Tai-Min/Farelka/hw/dummy_load/step/SK68-50SAFISCHER ELEKTRONIK.step

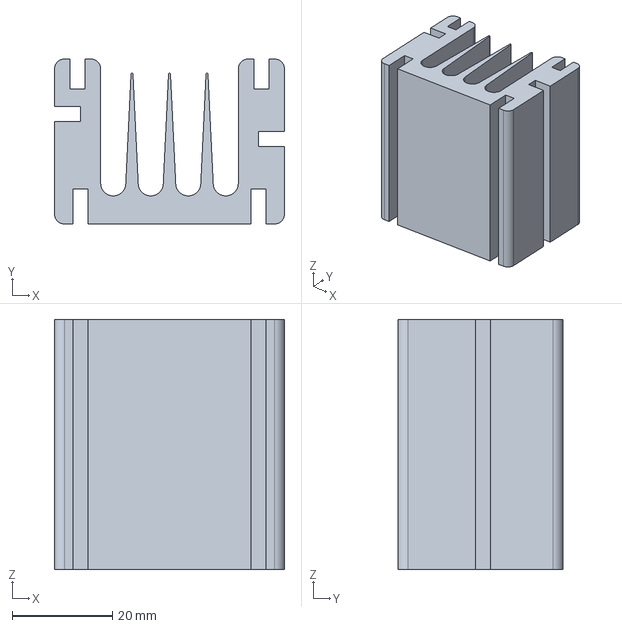
[picture p1: CAD file, 2025-12-17]
hw/dummy_load/step/SK68-50SAFISCHER ELEKTRONIK.step
46.0 x 33.0 x 50.0 mm
