Tai-Min/Farelka/hw/dummy_load/dummy_load.kicad_pcb

## KiCad design hw/dummy_load/dummy_load.kicad_pcb (2025-12-22)

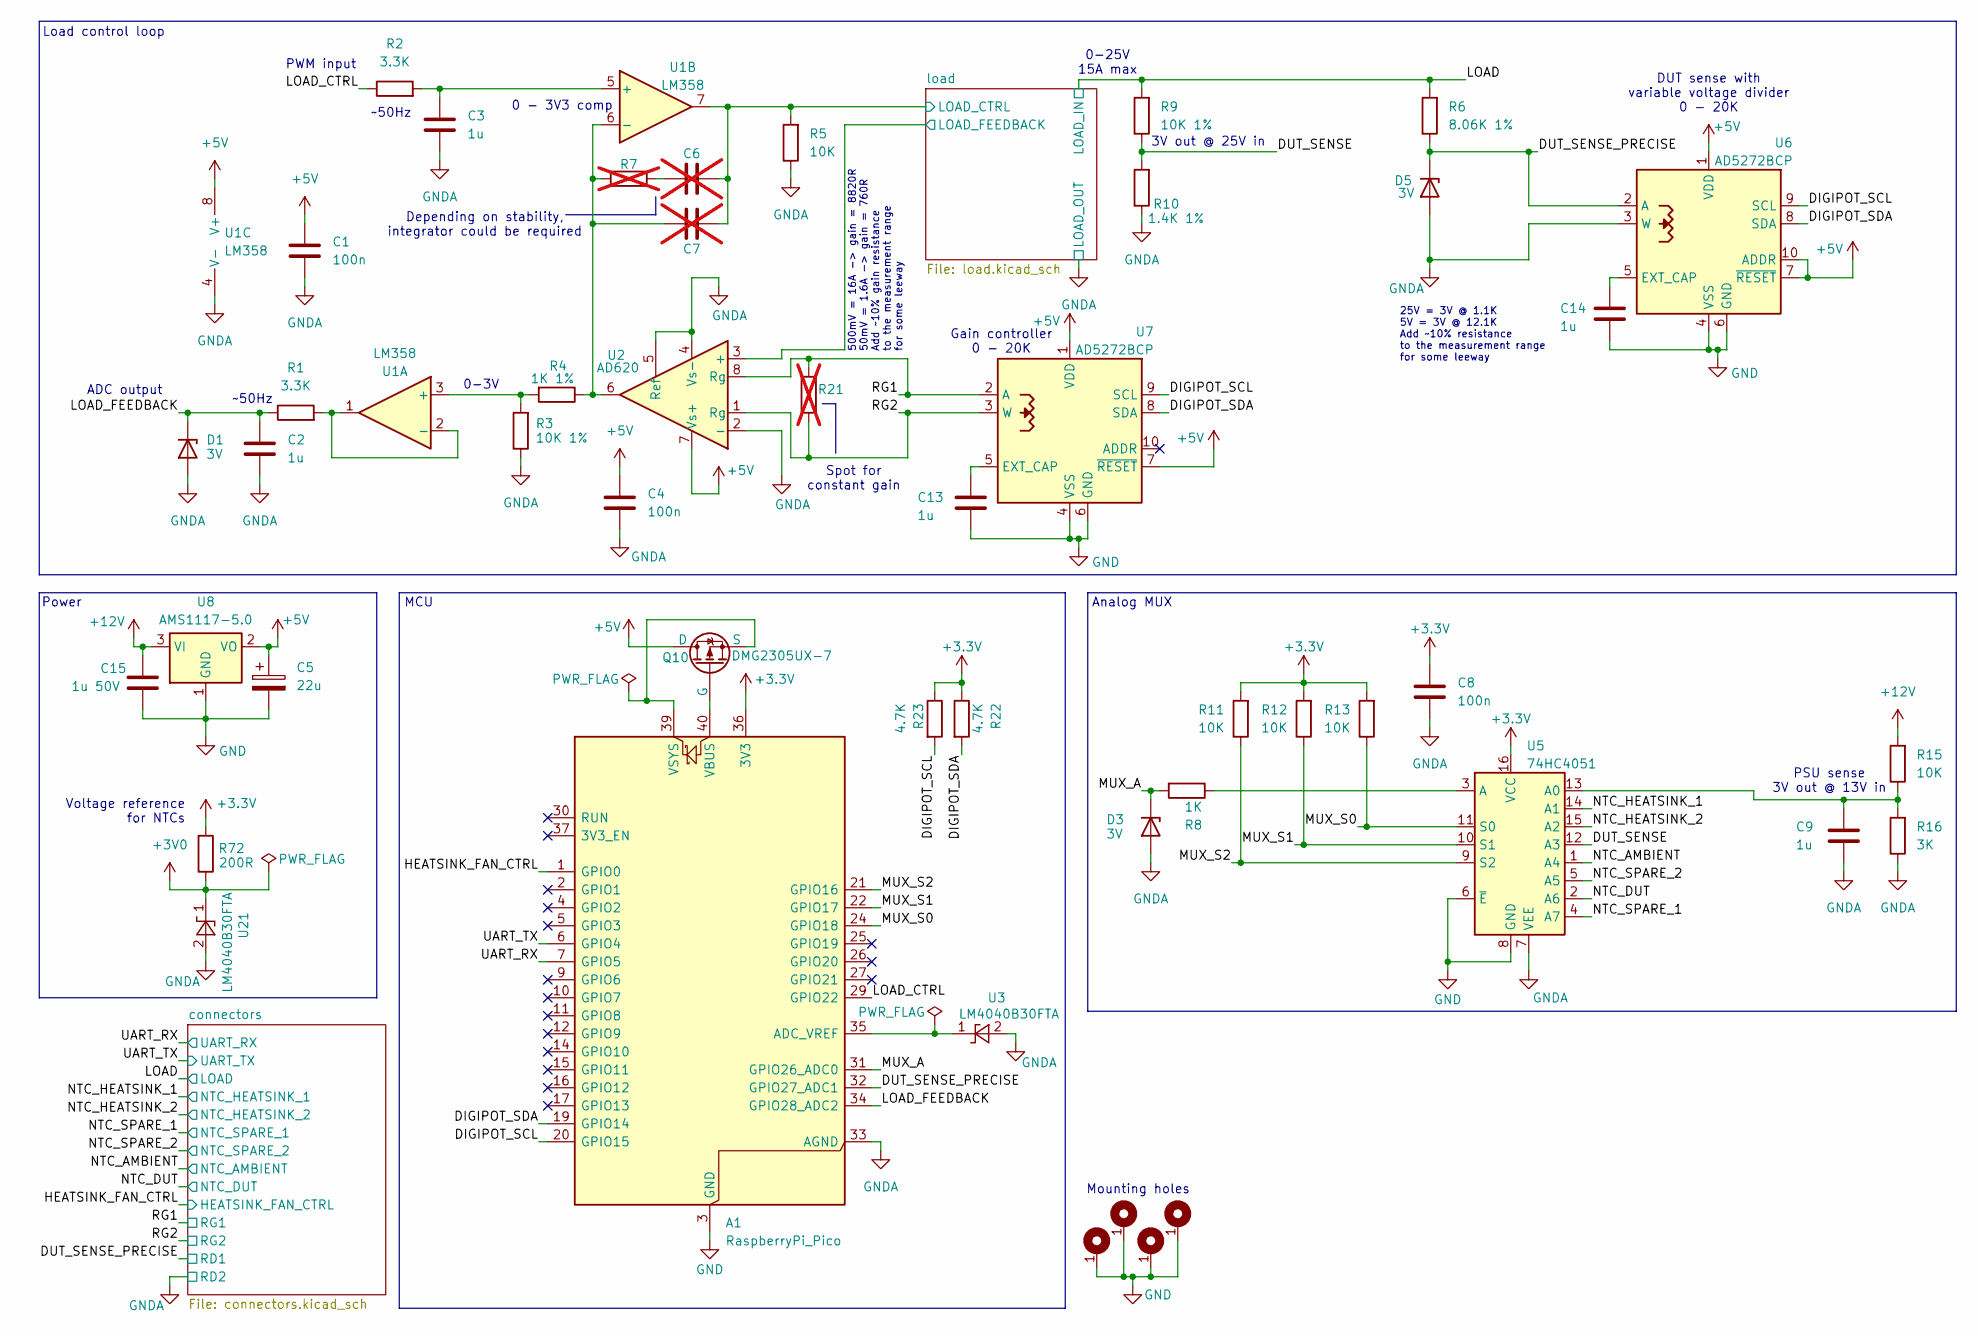
[picture p2: schematic dummy_load.kicad_sch, ${TITLE}]

Parts:
A1: RaspberryPi_Pico; RaspberryPi_Pico_Common_Unspecified
C1, C4, C8: 100n; C_0603_1608Metric; LCSC Part # C14663
C2, C3, C9, C13, C14: 1u; C_0603_1608Metric; LCSC Part # C15849
C5: 22u; C_1206_3216Metric; LCSC Part # C6328904
C6, C7: TDB; C_0603_1608Metric; not fitted
C15: 1u 50V; C_0603_1608Metric; LCSC Part # C15849
D1, D3, D5: 3V; D_SOD-123; LCSC Part # C2903916
H1, H2, H3, H4: MountingHole; MountingHole_3.2mm_M3_Pad_Via
Q10: DMG2305UX-7; SC-59; LCSC Part # C150470
R1, R2: 3.3K; R_0603_1608Metric; LCSC Part # C22978
R3, R9: 10K 1%; R_0603_1608Metric; LCSC Part # C98220
R4: 1K 1%; R_0603_1608Metric; LCSC Part # C22548
R5, R11, R12, R13, R15: 10K; R_0603_1608Metric; LCSC Part # C98220
R6: 8.06K 1%; R_0603_1608Metric; LCSC Part # C23112
R7, R21: TBD; R_0603_1608Metric; not fitted
R8: 1K; R_0603_1608Metric; LCSC Part # C22548
R10: 1.4K 1%; R_0603_1608Metric; LCSC Part # C25957
R16: 3K; R_0603_1608Metric; LCSC Part # C2907033
R22, R23: 4.7K; R_0603_1608Metric; LCSC Part # C99782
R72: 200R; R_0603_1608Metric; LCSC Part # C8218
U1: LM358; SOIC-8_3.9x4.9mm_P1.27mm; LCSC Part # C7950
U2: AD620; SOIC-8_3.9x4.9mm_P1.27mm; LCSC Part # C9675
U3, U21: LM4040B30FTA; SOT-23; LCSC Part # C460604
U5: 74HC4051; SOIC-16_3.9x9.9mm_P1.27mm; LCSC Part # C9386
U6, U7: AD5272BCP; LFCSP-WD-10-1EP_3x3mm_P0.5mm_EP1.64x2.38mm; LCSC Part # C649480
U8: AMS1117-5.0; SOT-223-3_TabPin2; LCSC Part # C6187

Connections:
+3.3V: A1.36 (3V3), C8.2, R11.2, R12.2, R13.2, R22.1, R23.1, R72.2, U5.16 (VCC); also elsewhere on the board
+3V0: R72.1, U21.1 (K); also elsewhere on the board
+5V: C1.2, C4.2, C5.1, Q10.3 (D), U1.8 (V+), U2.7 (Vs+), U6.1 (VDD), U6.7 (~RESET), U6.10 (ADDR), U7.1 (VDD), U7.7 (~RESET), U8.2 (VO)
+12V: C15.2, R15.2, U8.3 (VI); also elsewhere on the board
/DIGIPOT_SCL: A1.20 (GPIO15), R23.2, U6.9 (SCL), U7.9 (SCL)
/DIGIPOT_SDA: A1.19 (GPIO14), R22.2, U6.8 (SDA), U7.8 (SDA)
/DUT_SENSE: R9.1, R10.2, U5.12 (A3)
/DUT_SENSE_PRECISE: A1.32 (GPIO27_ADC1), D5.1 (K), R6.1, U6.2 (A); also elsewhere on the board
/HEATSINK_FAN_CTRL: A1.1 (GPIO0); also elsewhere on the board
/LOAD: R6.2, R9.2; also elsewhere on the board
/LOAD_CTRL: A1.29 (GPIO22), R2.1
/LOAD_FEEDBACK: A1.34 (GPIO28_ADC2), C2.2, D1.1 (K), R1.1
/MUX_A: A1.31 (GPIO26_ADC0), D3.1 (K), R8.2
/MUX_S0: A1.24 (GPIO18), R13.1, U5.11 (S0)
/MUX_S1: A1.22 (GPIO17), R12.1, U5.10 (S1)
/MUX_S2: A1.21 (GPIO16), R11.1, U5.9 (S2)
/NTC_AMBIENT: U5.1 (A4); also elsewhere on the board
/NTC_DUT: U5.2 (A6); also elsewhere on the board
/NTC_HEATSINK_1: U5.14 (A1); also elsewhere on the board
/NTC_HEATSINK_2: U5.15 (A2); also elsewhere on the board
/NTC_SPARE_1: U5.4 (A7); also elsewhere on the board
/NTC_SPARE_2: U5.5 (A5); also elsewhere on the board
/RG1: R21.2, U2.8 (Rg), U7.2 (A); also elsewhere on the board
/RG2: R21.1, U2.1 (Rg), U7.3 (W); also elsewhere on the board
/UART_RX: A1.7 (GPIO5); also elsewhere on the board
/UART_TX: A1.6 (GPIO4); also elsewhere on the board
/load/LOAD_CTRL: C6.1, C7.1, R5.2, U1.7; also elsewhere on the board
/load/LOAD_FEEDBACK: U2.3 (+); also elsewhere on the board
GND: A1.3 (GND), A1.8 (GND), A1.13 (GND), A1.18 (GND), A1.23 (GND), A1.28 (GND), A1.38 (GND), C5.2, C13.1, C14.1, C15.1, H1.1, H2.1, H3.1, H4.1, U5.6 (~E), U5.8 (GND), U6.4 (VSS), U6.6 (GND), U6.11 (VSS), U7.4 (VSS), U7.6 (GND), U7.11 (VSS), U8.1 (GND); also elsewhere on the board
GNDA: A1.33 (AGND), C1.1, C2.1, C3.1, C4.1, C8.1, C9.1, D1.2 (A), D3.2 (A), D5.2 (A), R3.1, R5.1, R10.1, R16.1, U1.4 (V-), U2.2 (-), U2.4 (Vs-), U2.5 (Ref), U3.2 (A), U5.7 (VEE), U6.3 (W), U21.2 (A); also elsewhere on the board
unnamed: A1.35 (ADC_VREF), U3.1 (K)
unnamed: A1.40 (VBUS), Q10.1 (G)
unnamed: A1.39 (VSYS), Q10.2 (S)
unnamed: C6.2, R7.2
unnamed: R3.2, R4.2, U1.3 (+)
unnamed: R1.2, U1.1, U1.2 (-)
unnamed: C3.2, R2.2, U1.5 (+)
unnamed: C7.2, R4.1, R7.1, U1.6 (-), U2.6
unnamed: C9.2, R15.1, R16.2, U5.13 (A0)
unnamed: R8.1, U5.3 (A)
unnamed: C14.2, U6.5 (EXT_CAP)
unnamed: C13.2, U7.5 (EXT_CAP)

Notes on the sheet:
~50Hz
MCU
0-3V
25V = 3V @ 1.1K 5V = 3V @ 12.1K Add ~10% resistance to the measurement range for some leeway
0 - 3V3 comp
Power
DUT sense with variable voltage divider 0 - 20K
ADC output
Gain controller 0 - 20K
500mV = 16A -> gain = 8820R 50mV = 1.6A -> gain = 760R Add ~10% gain resistance to the measurement range for some leeway
PSU sense 3V out @ 13V in
0-25V 15A max
Mounting holes
Depending on stability, integrator could be required
Analog MUX
Load control loop
Voltage reference for NTCs
Spot for constant gain
PWM input
3V out @ 25V in

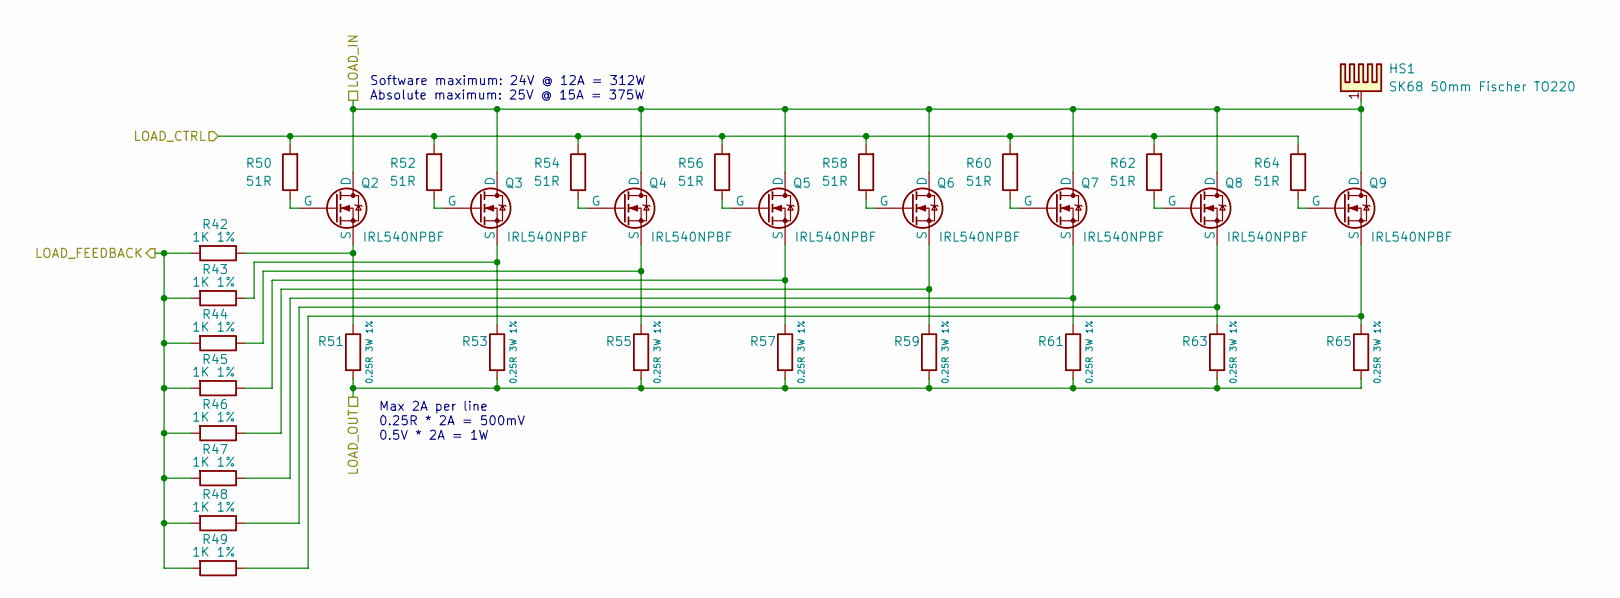
[picture p3: schematic load.kicad_sch]

Parts:
HS1: SK68 50mm Fischer TO220; Heatsink
Q2, Q3, Q4, Q5, Q6, Q7, Q8, Q9: IRL540NPBF; TO-220-3_Vertical; LCSC Part # C111607
R42, R43, R44, R45, R46, R47, R48, R49: 1K 1%; R_0603_1608Metric; LCSC Part # C22548
R50, R52, R54, R56, R58, R60, R62, R64: 51R; R_0603_1608Metric; LCSC Part # C2907181
R51, R53, R55, R57, R59, R61, R63, R65: 0.25R 3W 1%; R_2512_6332Metric; LCSC Part # C46634463

Connections:
/LOAD: HS1.1, Q2.2 (D), Q3.2 (D), Q4.2 (D), Q5.2 (D), Q6.2 (D), Q7.2 (D), Q8.2 (D), Q9.2 (D); also elsewhere on the board
/load/LOAD_CTRL: R50.2, R52.2, R54.2, R56.2, R58.2, R60.2, R62.2, R64.2; also elsewhere on the board
/load/LOAD_FEEDBACK: R42.2, R43.2, R44.2, R45.2, R46.2, R47.2, R48.2, R49.2; also elsewhere on the board
GNDA: R51.2, R53.2, R55.2, R57.2, R59.2, R61.2, R63.2, R65.2; also elsewhere on the board
unnamed: Q2.1 (G), R50.1
unnamed: Q2.3 (S), R42.1, R51.1
unnamed: Q3.1 (G), R52.1
unnamed: Q3.3 (S), R43.1, R53.1
unnamed: Q4.1 (G), R54.1
unnamed: Q4.3 (S), R44.1, R55.1
unnamed: Q5.1 (G), R56.1
unnamed: Q5.3 (S), R45.1, R57.1
unnamed: Q6.1 (G), R58.1
unnamed: Q6.3 (S), R46.1, R59.1
unnamed: Q7.1 (G), R60.1
unnamed: Q7.3 (S), R47.1, R61.1
unnamed: Q8.1 (G), R62.1
unnamed: Q8.3 (S), R48.1, R63.1
unnamed: Q9.1 (G), R64.1
unnamed: Q9.3 (S), R49.1, R65.1

Notes on the sheet:
Software maximum: 24V @ 12A = 312W Absolute maximum: 25V @ 15A = 375W
Max 2A per line 0.25R * 2A = 500mV 0.5V * 2A = 1W

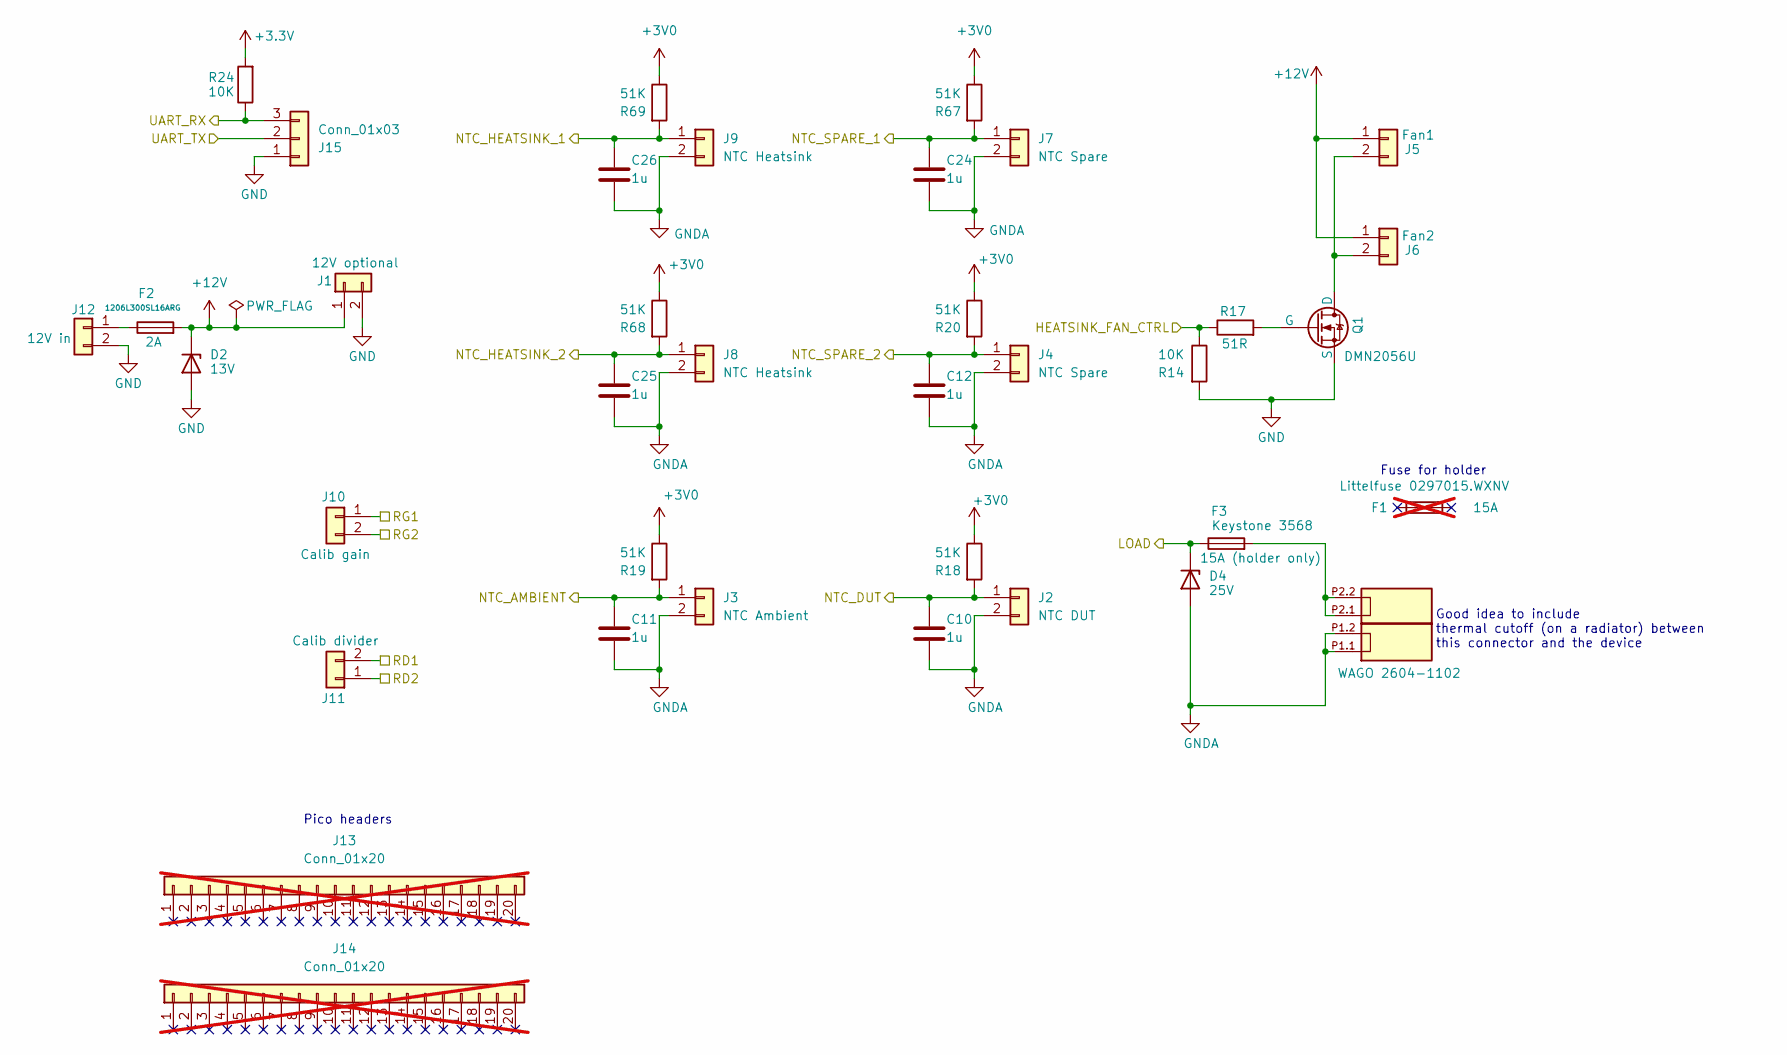
[picture p4: schematic connectors.kicad_sch]

Parts:
C10, C11, C12, C24, C25, C26: 1u; C_0603_1608Metric; LCSC Part # C15849
D2: 13V; D_SOD-123; LCSC Part # C48587209
D4: 25V; D_SOD-123; LCSC Part # C525407
F1: Littelfuse 0297015.WXNV; LCSC Part # C151095; not fitted
F2: 1206L300SL16ARG; Fuse_1206_3216Metric; LCSC Part # C28326707
F3: Keystone 3568; Fuseholder_Blade_Mini_Keystone_3568; LCSC Part # C5249699
J1: 12V optional; JST_XH_B2B-XH-A_1x02_P2.50mm_Vertical; LCSC Part # C158012
J2: NTC DUT; JST_XH_B2B-XH-A_1x02_P2.50mm_Vertical; LCSC Part # C158012
J3: NTC Ambient; JST_XH_B2B-XH-A_1x02_P2.50mm_Vertical; LCSC Part # C158012
J4, J7: NTC Spare; JST_XH_B2B-XH-A_1x02_P2.50mm_Vertical; LCSC Part # C158012
J5: Fan1; JST_XH_B2B-XH-A_1x02_P2.50mm_Vertical; LCSC Part # C158012
J6: Fan2; JST_XH_B2B-XH-A_1x02_P2.50mm_Vertical; LCSC Part # C158012
J8, J9: NTC Heatsink; JST_XH_B2B-XH-A_1x02_P2.50mm_Vertical; LCSC Part # C158012
J10: Calib gain; JST_XH_B2B-XH-A_1x02_P2.50mm_Vertical; LCSC Part # C158012
J11: Calib divider; JST_XH_B2B-XH-A_1x02_P2.50mm_Vertical; LCSC Part # C158012
J12: 12V in; JST_XH_B2B-XH-A_1x02_P2.50mm_Vertical; LCSC Part # C158012
J13, J14: Conn_01x20; LCSC Part # C18078139; not fitted
J15: Conn_01x03; JST_XH_B3B-XH-A_1x03_P2.50mm_Vertical; LCSC Part # C144394
Q1: DMN2056U; TSOT-23; LCSC Part # C332302
R14, R24: 10K; R_0603_1608Metric; LCSC Part # C98220
R17: 51R; R_0603_1608Metric; LCSC Part # C2907181
R18, R19, R20, R67, R68, R69: 51K; R_0603_1608Metric; LCSC Part # C107231
X1: WAGO 2604-1102; WAGO-2604-1102

Connections:
+3.3V: R24.2; also elsewhere on the board
+3V0: R18.1, R19.1, R20.1, R67.1, R68.1, R69.1; also elsewhere on the board
+12V: D2.1 (K), F2.2, J1.1, J5.1, J6.1; also elsewhere on the board
/DUT_SENSE_PRECISE: J11.2; also elsewhere on the board
/HEATSINK_FAN_CTRL: R14.1, R17.1; also elsewhere on the board
/LOAD: D4.1 (K), F3.1; also elsewhere on the board
/NTC_AMBIENT: C11.2, J3.1, R19.2; also elsewhere on the board
/NTC_DUT: C10.2, J2.1, R18.2; also elsewhere on the board
/NTC_HEATSINK_1: C26.2, J9.1, R69.2; also elsewhere on the board
/NTC_HEATSINK_2: C25.2, J8.1, R68.2; also elsewhere on the board
/NTC_SPARE_1: C24.2, J7.1, R67.2; also elsewhere on the board
/NTC_SPARE_2: C12.2, J4.1, R20.2; also elsewhere on the board
/RG1: J10.1; also elsewhere on the board
/RG2: J10.2; also elsewhere on the board
/UART_RX: J15.3, R24.1; also elsewhere on the board
/UART_TX: J15.2; also elsewhere on the board
GND: D2.2 (A), J1.2, J12.2, J15.1, Q1.2 (S), R14.2; also elsewhere on the board
GNDA: C10.1, C11.1, C12.1, C24.1, C25.1, C26.1, D4.2 (A), J2.2, J3.2, J4.2, J7.2, J8.2, J9.2, J11.1, X1.P1.1, X1.P1.2; also elsewhere on the board
unnamed: F3.2, X1.P2.1, X1.P2.2
unnamed: J5.2, J6.2, Q1.3 (D)
unnamed: F2.1, J12.1
unnamed: Q1.1 (G), R17.2

Notes on the sheet:
Pico headers
Good idea to include thermal cutoff (on a radiator) between this connector and the device
Fuse for holder

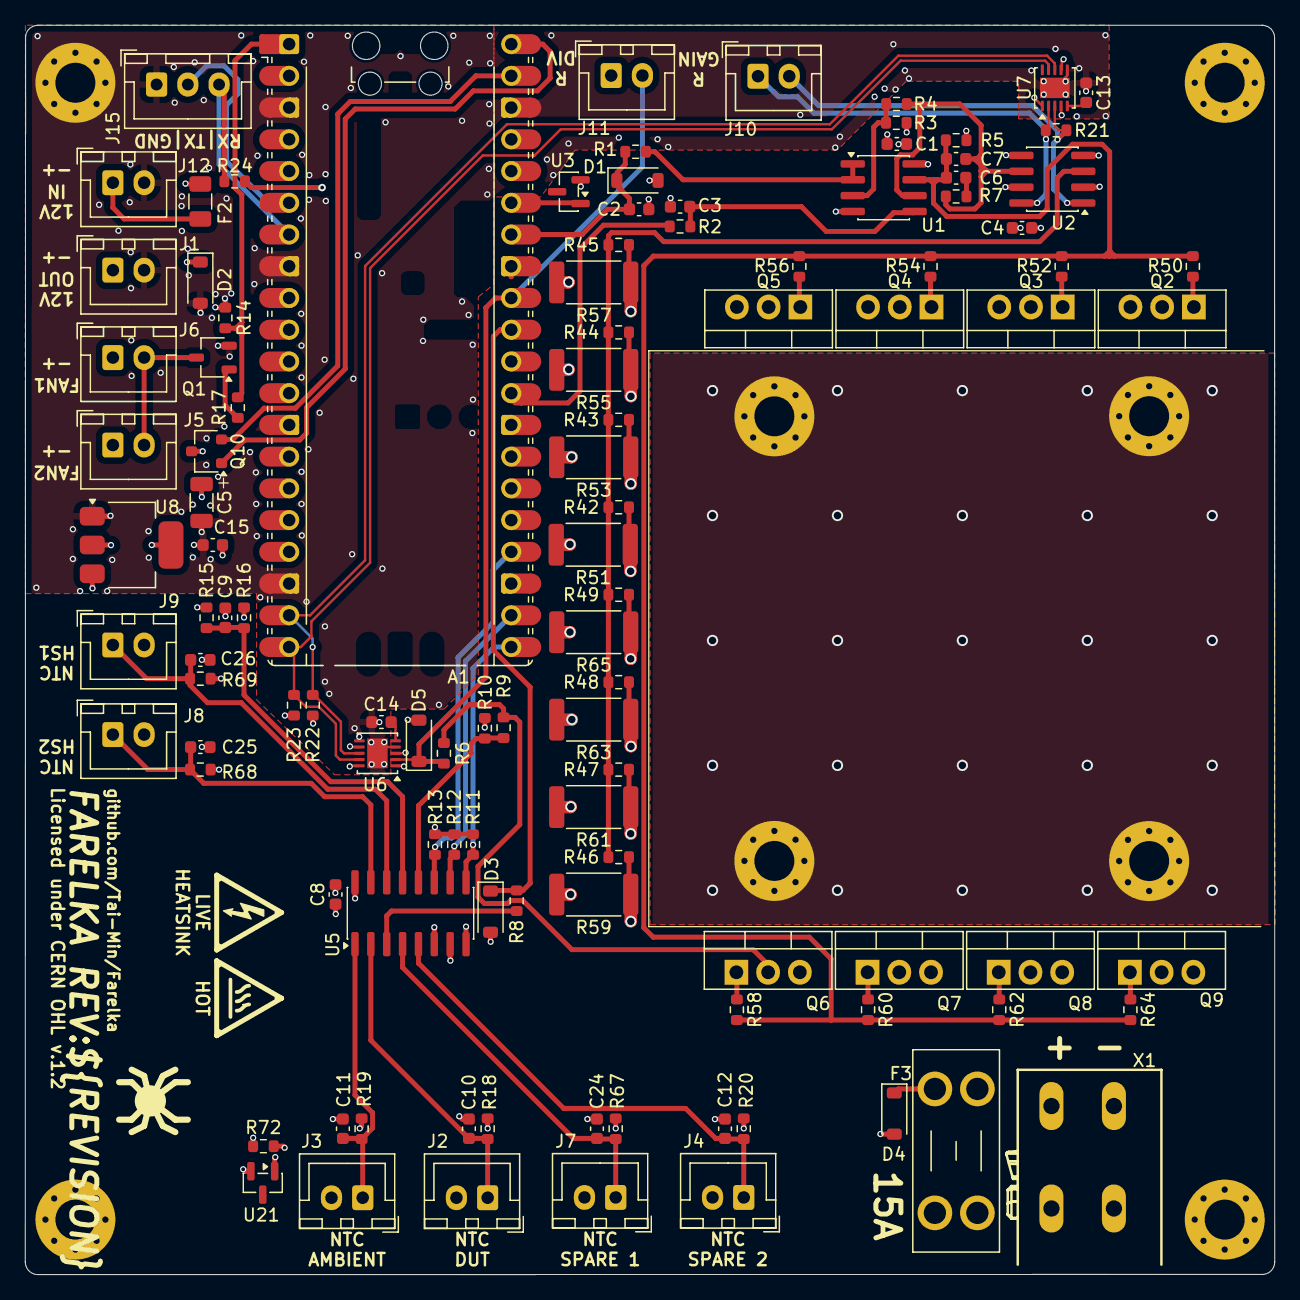
[picture p5: board dummy_load.kicad_pcb from above]

Board: 4 copper layers, 100.0 x 100.0 mm, 115 parts (0 on the bottom side), 62 nets.
