Tai-Min/Farelka/(commit log)

2025-12-17 Add dummy load initial revision (#1)
    * Add dummy load initial revision
    * Minor repo fixes
    * Add inner layers to board2pdf.config.ini
    * Fix digipot cap value
    * Fix hotspot, remove old schematic file
    ---------
    [SK68-50SAFISCHER ELEKTRONIK.step, connectors.kicad_sch, dummy_load.kicad_pcb, dummy_load.kicad_sch, load.kicad_sch]
2025-12-17 Replace terminal block, update BOM and datasheets, minor fixes to tracing (#2)
    [connectors.kicad_sch, dummy_load.kicad_pcb, load.kicad_sch]
2025-12-18 Add license on silkscreen (#5)
    * Add license on silkscreen
    * Add more vias
    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
    [dummy_load.kicad_pcb]
2025-12-22 Better PCB design, update BOM, add UART header for debugging (#7)
    [connectors.kicad_sch, dummy_load.kicad_pcb, dummy_load.kicad_sch, load.kicad_sch]
