Tai-Min/Farelka/(notices)

Notices in the files:
hw/dummy_load/dummy_load.kicad_pcb:
Licensed under CERN OHL v.1.2
